pp-code-1201/Functional-Electrical-Stimulation/README.md

# Functional-Electrical-Stimulation
design of Functional-Electrical-Stimulation
