pp-code-1201/Functional-Electrical-Stimulation/fes测试结果总结/下肢_可实现的动作.docx

动作一：脚腕背屈，也称之为足内翻

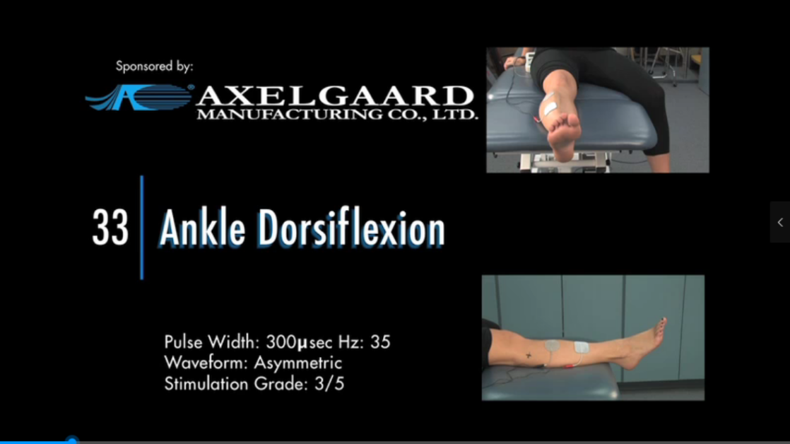
[picture p1: figure]
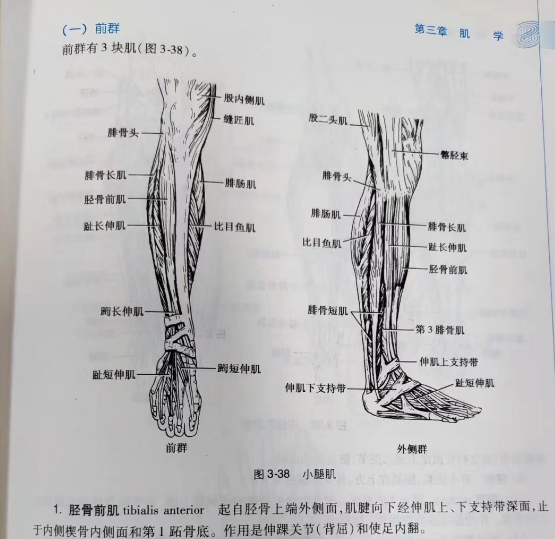
[picture p2: figure]

作用点为胫骨前肌

胫骨前肌位置：胫骨外侧面，也即腿部前侧远离身体的一侧，约在膝盖骨下侧5-10cm的位置，作用主要电极为下图的上方的电极片

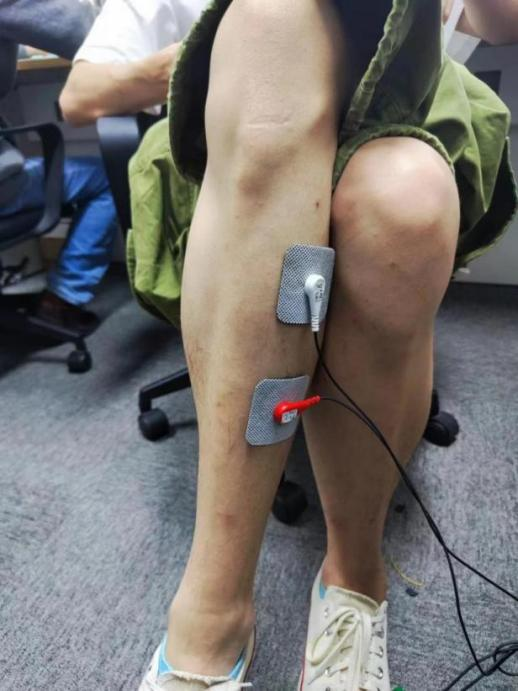
[picture p3: figure]
769a560509062b690e53f191cb9bba6
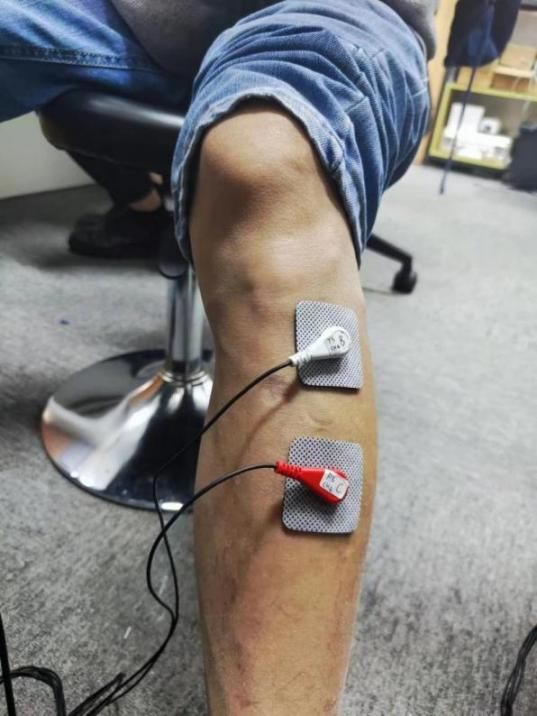
[picture p4: figure]
6eee9dab7c4d59fee65476bd0939f17
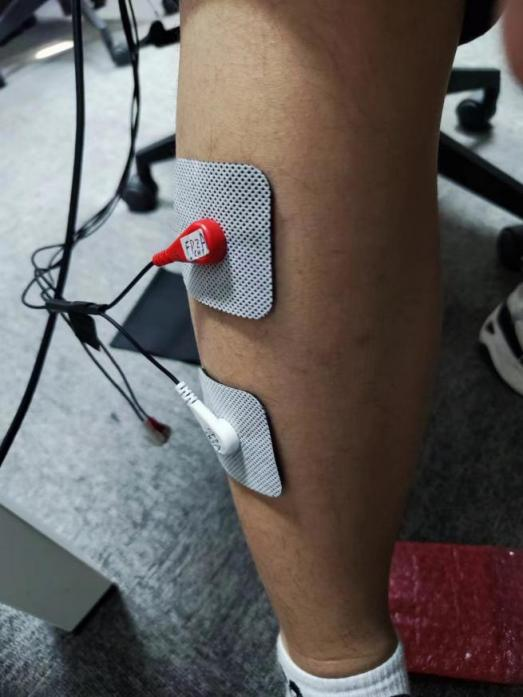
[picture p5: figure]
1687cea35207629f05cc6928171d927

电极片间距：4-4.5cm

电极片中心距：8cm

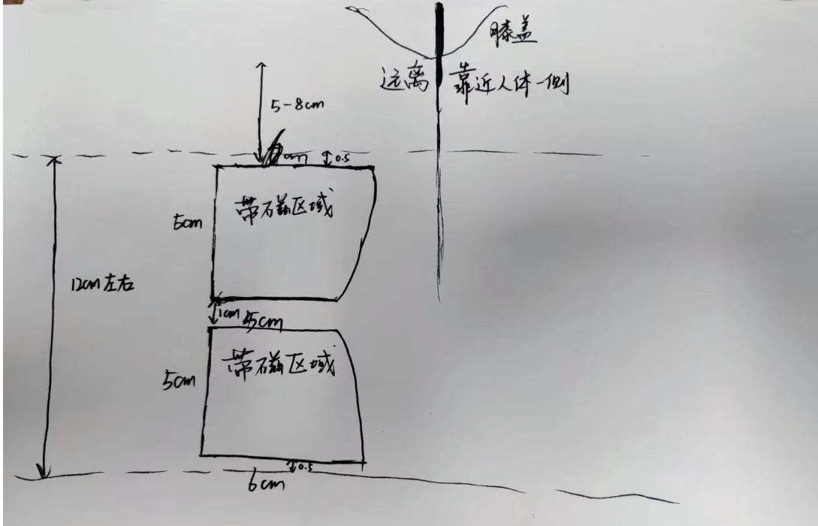
[picture p6: figure]
4de929856596f13bfcb09e4be4cfbc7
