pp-code-1201/Functional-Electrical-Stimulation/hardware/FES_SCH_V2.5.pdf

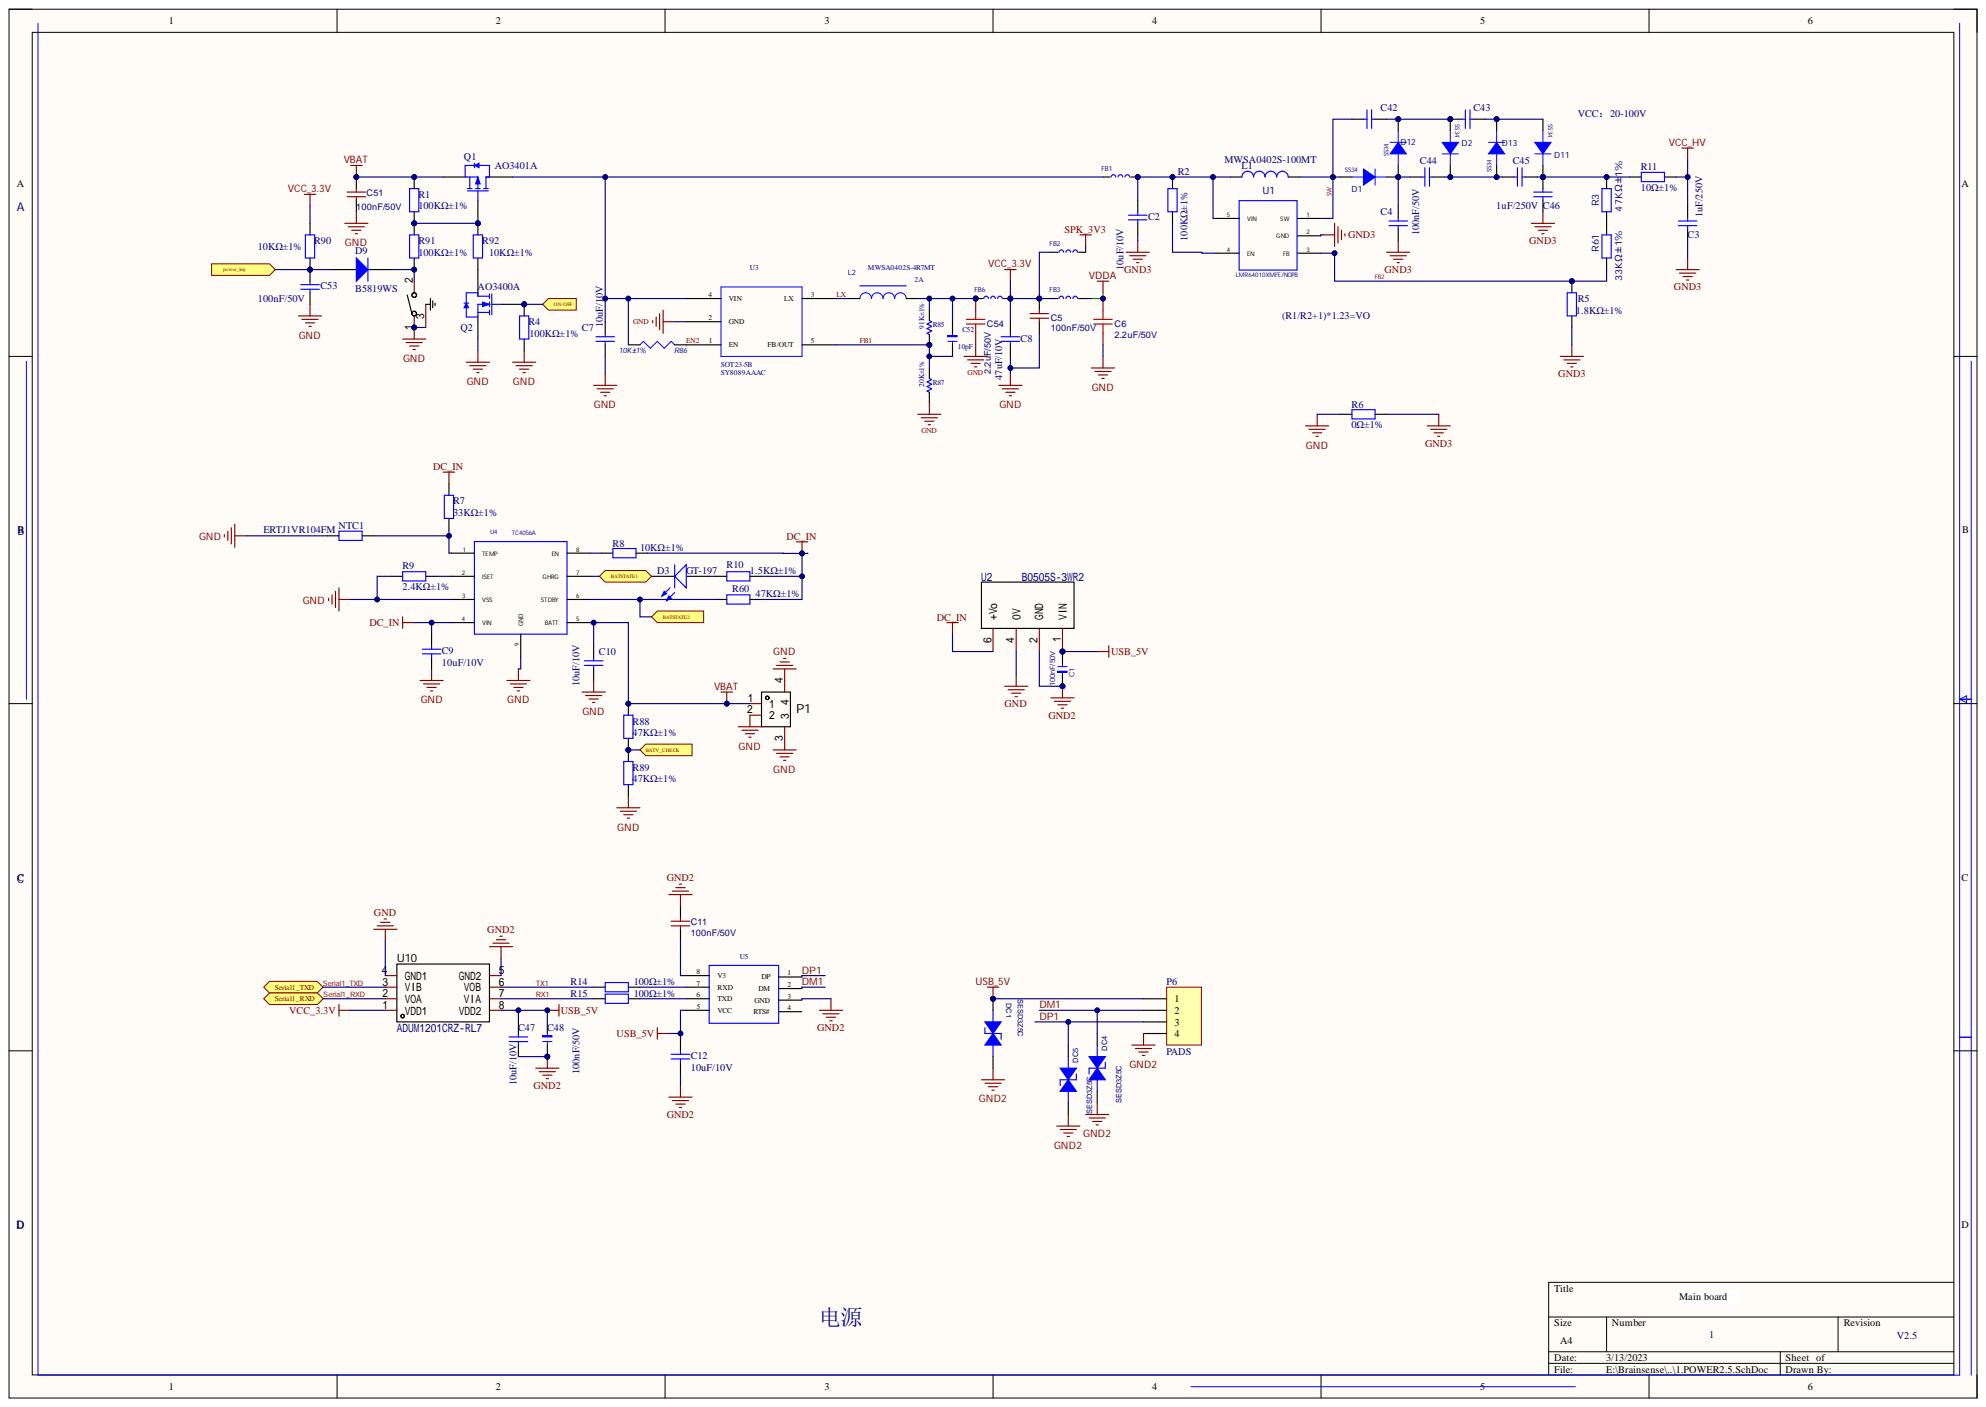
[picture p7: page 1]

GND 2

Size A4 | Number 1 | Revision V2.5

Date: 3/13/2023 | Sheet of
File: E:\Brainsense\..\1.POWER2.5.SchDoc | Drawn By:

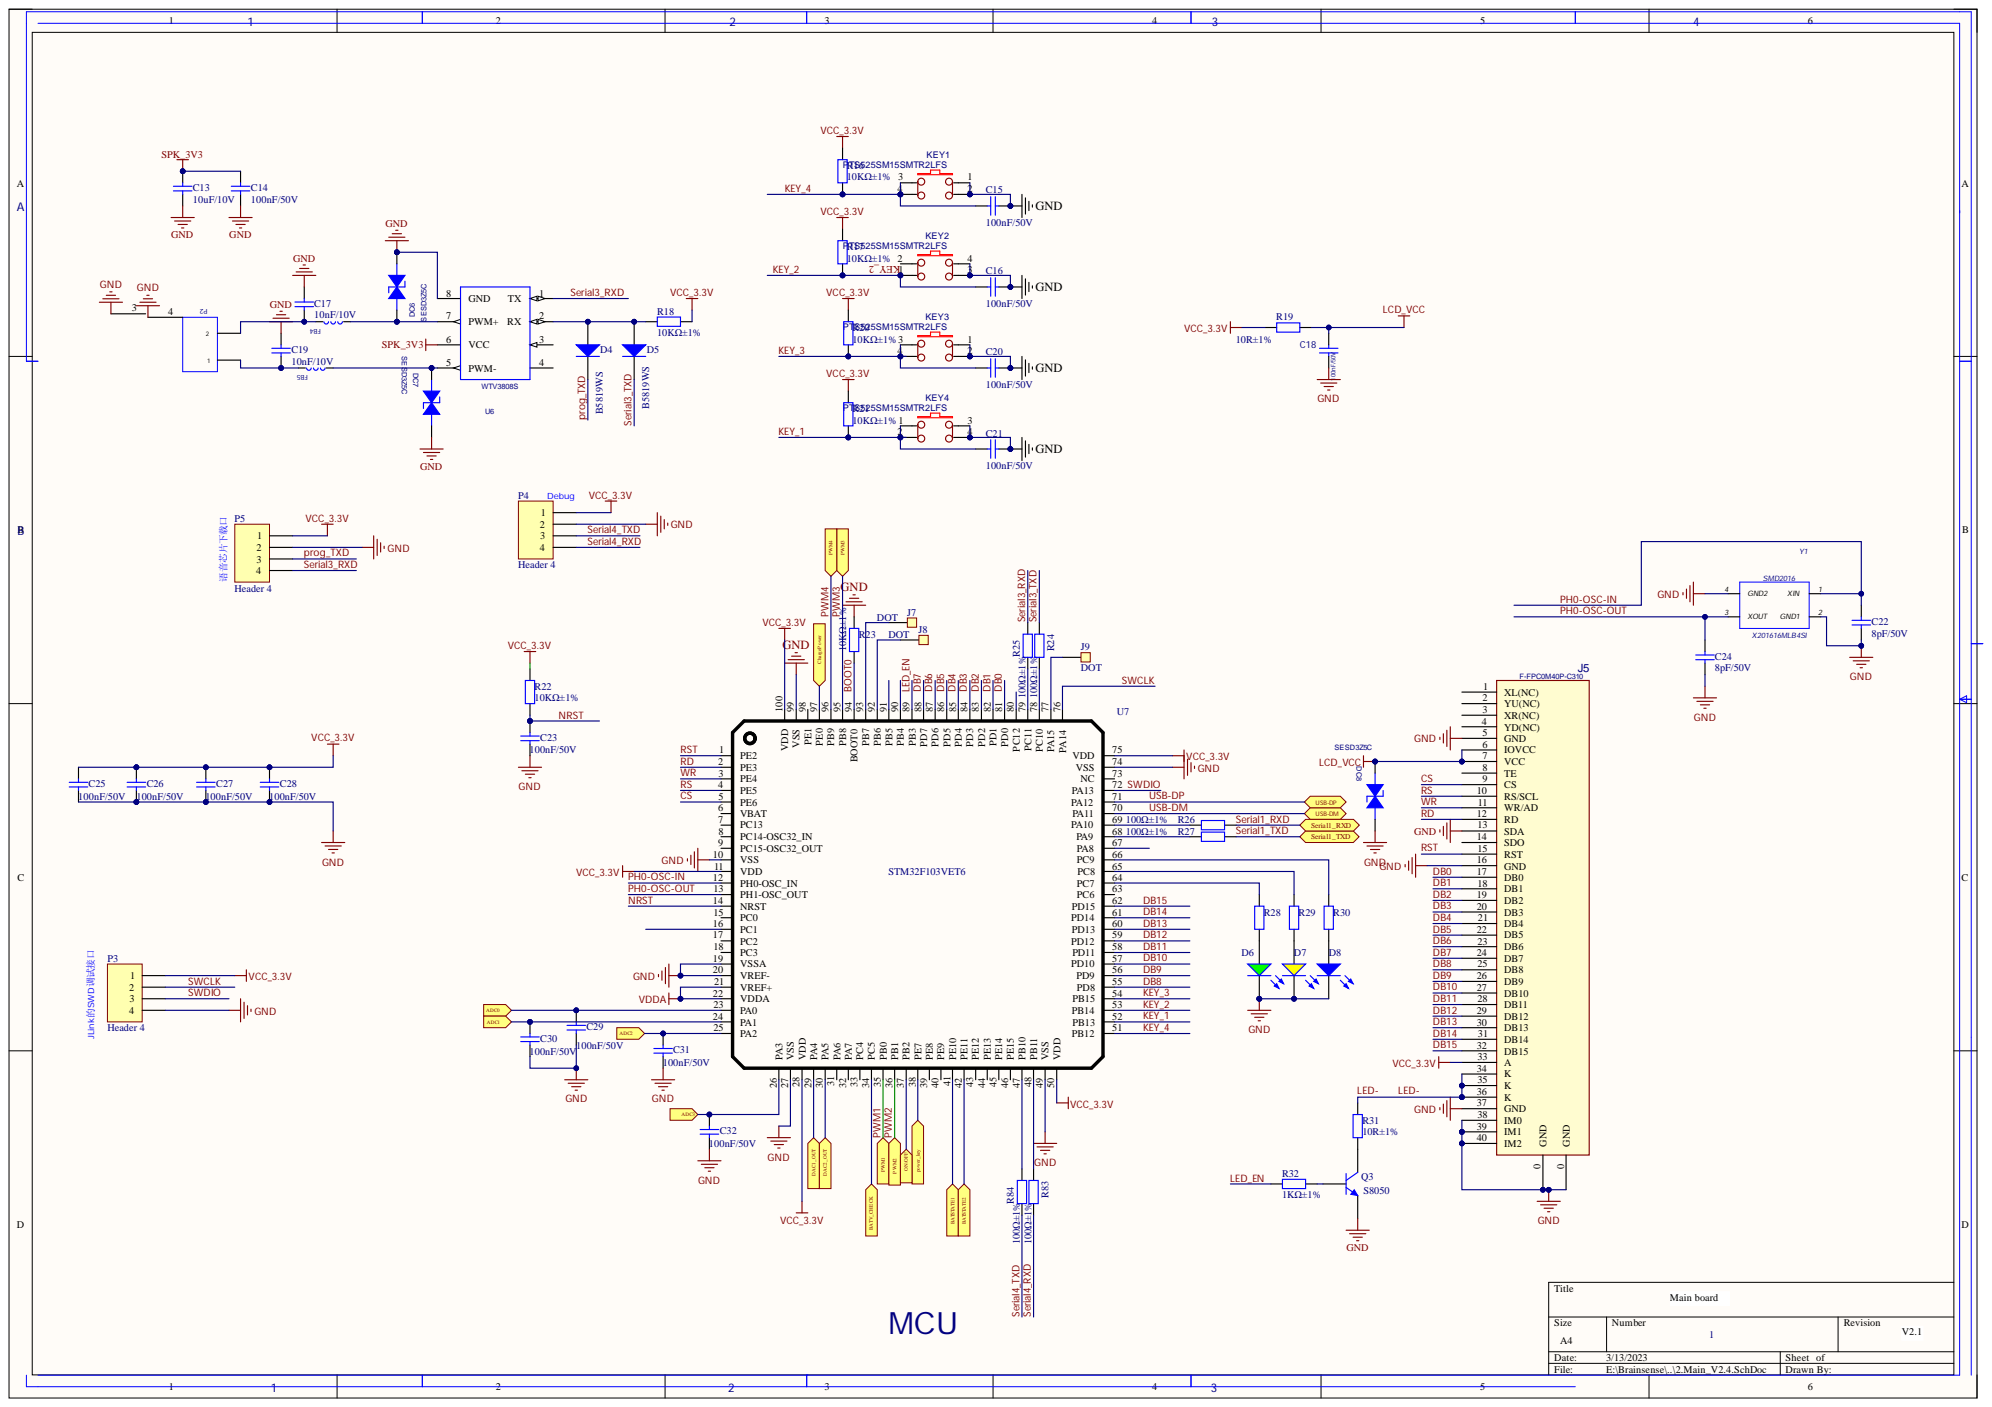
[picture p8: page 2]

Title

Size A4 | Nu mber | Revision

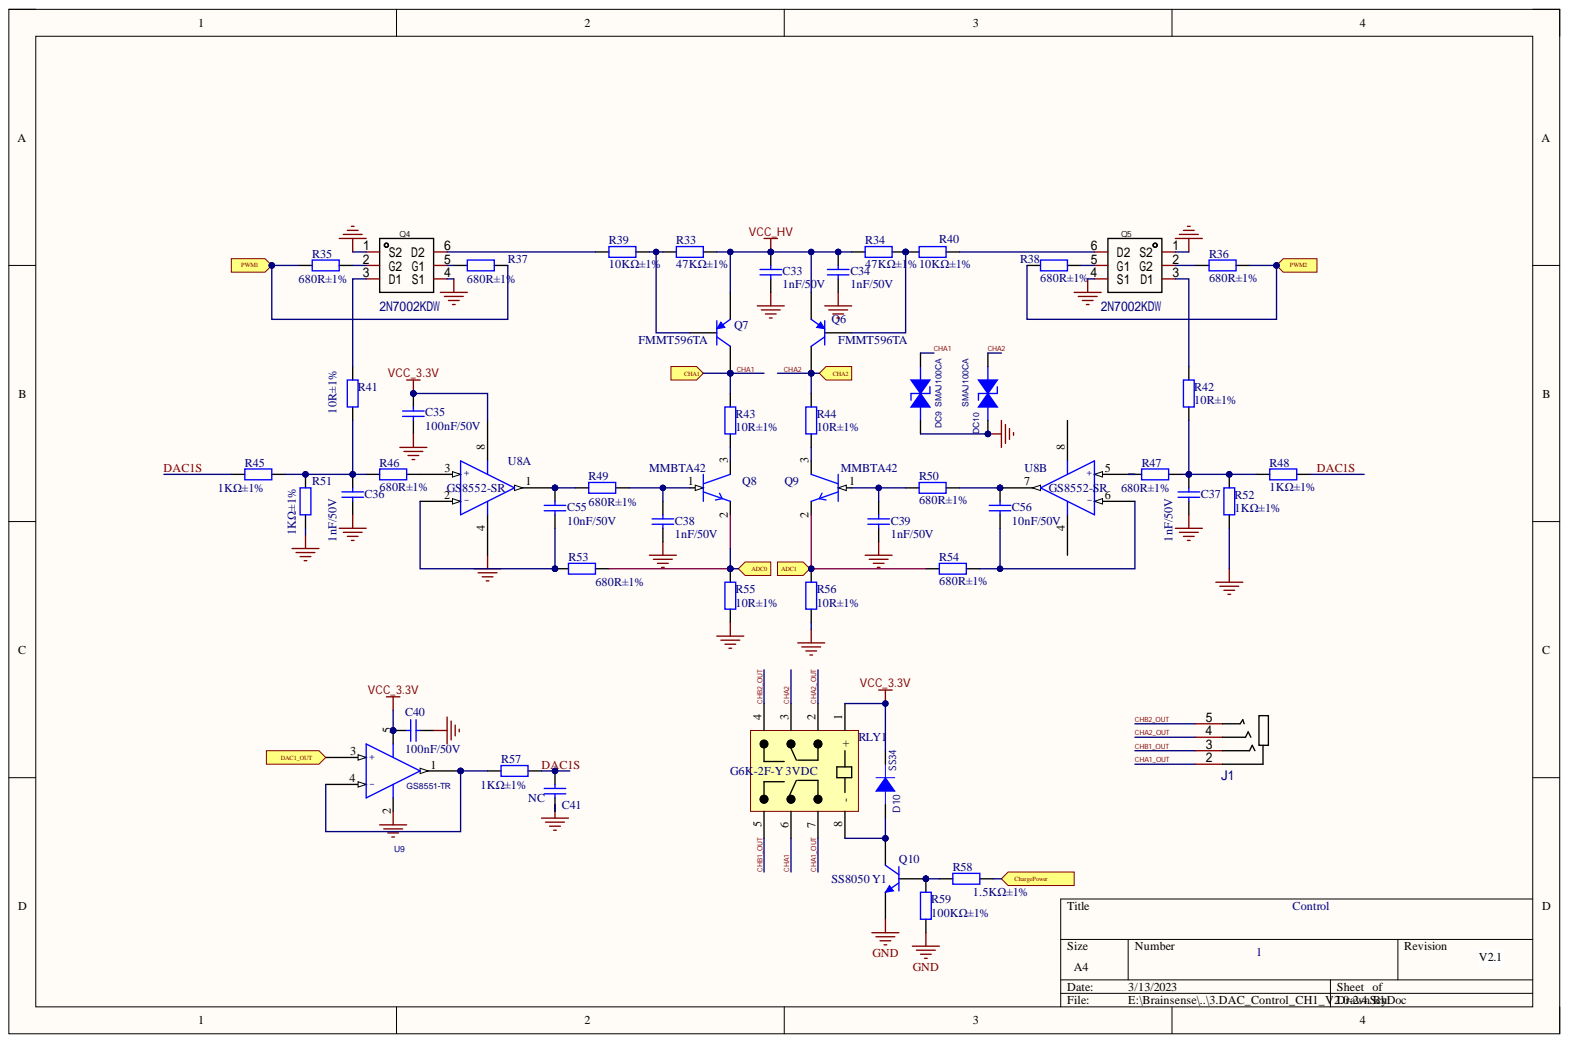
[picture p9: page 3]
