pp-code-1201/Functional-Electrical-Stimulation/(list of files, drawings)

Other design files:
hardware/1.POWER2.5.SchDoc
hardware/2.Main_V2.4.SchDoc
hardware/3.DAC_Control_CH1_V2.0-2.4.SchDoc
