pp-code-1201/Functional-Electrical-Stimulation/software/Core/Inc/main.h

#define LCD_RST_Pin GPIO_PIN_2
#define LCD_RST_GPIO_Port GPIOE
#define LCD_RD_Pin GPIO_PIN_3
#define LCD_RD_GPIO_Port GPIOE
#define LCD_WR_Pin GPIO_PIN_4
#define LCD_WR_GPIO_Port GPIOE
#define LCD_RS_Pin GPIO_PIN_5
#define LCD_RS_GPIO_Port GPIOE
#define LCD_CS_Pin GPIO_PIN_6
#define LCD_CS_GPIO_Port GPIOE
#define charge_full_Pin GPIO_PIN_7
#define charge_full_GPIO_Port GPIOA
#define charging_Pin GPIO_PIN_4
#define charging_GPIO_Port GPIOC
#define ON_OFF_Pin GPIO_PIN_2
#define ON_OFF_GPIO_Port GPIOB
#define POWER_KEY_Pin GPIO_PIN_7
#define POWER_KEY_GPIO_Port GPIOE
#define POWER_KEY_EXTI_IRQn EXTI9_5_IRQn
#define KEY_1_Pin GPIO_PIN_12
#define KEY_1_GPIO_Port GPIOB
#define KEY_1_EXTI_IRQn EXTI15_10_IRQn
#define KEY_4_Pin GPIO_PIN_13
#define KEY_4_GPIO_Port GPIOB
#define KEY_4_EXTI_IRQn EXTI15_10_IRQn
#define KEY_2_Pin GPIO_PIN_14
#define KEY_2_GPIO_Port GPIOB
#define KEY_2_EXTI_IRQn EXTI15_10_IRQn
#define KEY_3_Pin GPIO_PIN_15
#define KEY_3_GPIO_Port GPIOB
#define KEY_3_EXTI_IRQn EXTI15_10_IRQn
#define LED_B_Pin GPIO_PIN_7
#define LED_B_GPIO_Port GPIOC
#define LED_Y_Pin GPIO_PIN_8
#define LED_Y_GPIO_Port GPIOC
#define LED_R_Pin GPIO_PIN_9
#define LED_R_GPIO_Port GPIOC
#define LCD_BL_Pin GPIO_PIN_3
#define LCD_BL_GPIO_Port GPIOB
#define channel_switch_Pin GPIO_PIN_0
#define channel_switch_GPIO_Port GPIOE
