pp-code-1201/Functional-Electrical-Stimulation/software/Core/Src/usart.c

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
/* Includes ------------------------------------------------------------------*/
#include "usart.h"

/* USER CODE BEGIN 0 */
uint8_t  USART1_RX_BUF[USART_RX_LEN] = {0}; 
uint16_t USART1_RX_STA=0;   
uint8_t  ReviceState1 = 0;

/* USER CODE END 0 */

UART_HandleTypeDef huart4;
UART_HandleTypeDef huart1;
UART_HandleTypeDef huart3;

/* UART4 init function */
void MX_UART4_Init(void)
{

  huart4.Instance = UART4;
  huart4.Init.BaudRate = 9600;
  huart4.Init.WordLength = UART_WORDLENGTH_8B;
  huart4.Init.StopBits = UART_STOPBITS_1;
  huart4.Init.Parity = UART_PARITY_NONE;
  huart4.Init.Mode = UART_MODE_TX_RX;
  huart4.Init.HwFlowCtl = UART_HWCONTROL_NONE;
  huart4.Init.OverSampling = UART_OVERSAMPLING_16;
  if (HAL_UART_Init(&huart4) != HAL_OK)
  {
    Error_Handler();
  }
}
/* USART1 init function */

void MX_USART1_UART_Init(void)
{

  huart1.Instance = USART1;
  huart1.Init.BaudRate = 115200;
  huart1.Init.WordLength = UART_WORDLENGTH_8B;
  huart1.Init.StopBits = UART_STOPBITS_1;
  huart1.Init.Parity = UART_PARITY_NONE;
  huart1.Init.Mode = UART_MODE_TX_RX;
  huart1.Init.HwFlowCtl = UART_HWCONTROL_NONE;
  huart1.Init.OverSampling = UART_OVERSAMPLING_16;
  if (HAL_UART_Init(&huart1) != HAL_OK)
  {
    Error_Handler();
  }
  /* USER CODE BEGIN USART1_Init 2 */
  __HAL_UART_ENABLE_IT(&huart1, UART_IT_RXNE);
	__HAL_UART_ENABLE_IT(&huart1, UART_IT_IDLE);
  /* USER CODE END USART1_Init 2 */

}
/* USART3 init function */

void MX_USART3_UART_Init(void)
{

  huart3.Instance = USART3;
  huart3.Init.BaudRate = 115200;
  huart3.Init.WordLength = UART_WORDLENGTH_8B;
  huart3.Init.StopBits = UART_STOPBITS_1;
  huart3.Init.Parity = UART_PARITY_NONE;
  huart3.Init.Mode = UART_MODE_TX_RX;
  huart3.Init.HwFlowCtl = UART_HWCONTROL_NONE;
  huart3.Init.OverSampling = UART_OVERSAMPLING_16;
  if (HAL_UART_Init(&huart3) != HAL_OK)
  {
    Error_Handler();
  }
}

void HAL_UART_MspInit(UART_HandleTypeDef* uartHandle)
{

  GPIO_InitTypeDef GPIO_InitStruct = {0};
  if(uartHandle->Instance==UART4)
  {
    /* UART4 clock enable */
    __HAL_RCC_UART4_CLK_ENABLE();

    __HAL_RCC_GPIOC_CLK_ENABLE();
    /**UART4 GPIO Configuration
    PC10     ------> UART4_TX
    PC11     ------> UART4_RX
    */
    GPIO_InitStruct.Pin = GPIO_PIN_10;
    GPIO_InitStruct.Mode = GPIO_MODE_AF_PP;
    GPIO_InitStruct.Speed = GPIO_SPEED_FREQ_HIGH;
    HAL_GPIO_Init(GPIOC, &GPIO_InitStruct);

    GPIO_InitStruct.Pin = GPIO_PIN_11;
    GPIO_InitStruct.Mode = GPIO_MODE_INPUT;
    GPIO_InitStruct.Pull = GPIO_NOPULL;
    HAL_GPIO_Init(GPIOC, &GPIO_InitStruct);

    /* UART4 interrupt Init */
    HAL_NVIC_SetPriority(UART4_IRQn, 4, 0);
    HAL_NVIC_EnableIRQ(UART4_IRQn);
  }
  else if(uartHandle->Instance==USART1)
  {
    /* USART1 clock enable */
    __HAL_RCC_USART1_CLK_ENABLE();

    __HAL_RCC_GPIOA_CLK_ENABLE();
    /**USART1 GPIO Configuration
    PA9     ------> USART1_TX
    PA10     ------> USART1_RX
    */
    GPIO_InitStruct.Pin = GPIO_PIN_9;
    GPIO_InitStruct.Mode = GPIO_MODE_AF_PP;
    GPIO_InitStruct.Speed = GPIO_SPEED_FREQ_HIGH;
    HAL_GPIO_Init(GPIOA, &GPIO_InitStruct);

    GPIO_InitStruct.Pin = GPIO_PIN_10;
    GPIO_InitStruct.Mode = GPIO_MODE_INPUT;
    GPIO_InitStruct.Pull = GPIO_NOPULL;
    HAL_GPIO_Init(GPIOA, &GPIO_InitStruct);

    /* USART1 interrupt Init */
    HAL_NVIC_SetPriority(USART1_IRQn, 3, 0);
    HAL_NVIC_EnableIRQ(USART1_IRQn);
  }
  else if(uartHandle->Instance==USART3)
  {
    /* USART3 clock enable */
    __HAL_RCC_USART3_CLK_ENABLE();

    __HAL_RCC_GPIOB_CLK_ENABLE();
    /**USART3 GPIO Configuration
    PB10     ------> USART3_TX
    PB11     ------> USART3_RX
    */
    GPIO_InitStruct.Pin = GPIO_PIN_10;
    GPIO_InitStruct.Mode = GPIO_MODE_AF_PP;
    GPIO_InitStruct.Speed = GPIO_SPEED_FREQ_HIGH;
    HAL_GPIO_Init(GPIOB, &GPIO_InitStruct);

    GPIO_InitStruct.Pin = GPIO_PIN_11;
    GPIO_InitStruct.Mode = GPIO_MODE_INPUT;
    GPIO_InitStruct.Pull = GPIO_NOPULL;
    HAL_GPIO_Init(GPIOB, &GPIO_InitStruct);

  }
}

void HAL_UART_MspDeInit(UART_HandleTypeDef* uartHandle)
{

  if(uartHandle->Instance==UART4)
  {
    /* Peripheral clock disable */
    __HAL_RCC_UART4_CLK_DISABLE();

    /**UART4 GPIO Configuration
    PC10     ------> UART4_TX
    PC11     ------> UART4_RX
    */
    HAL_GPIO_DeInit(GPIOC, GPIO_PIN_10|GPIO_PIN_11);

    /* UART4 interrupt Deinit */
    HAL_NVIC_DisableIRQ(UART4_IRQn);
  }
  else if(uartHandle->Instance==USART1)
  {
    /* Peripheral clock disable */
    __HAL_RCC_USART1_CLK_DISABLE();

    /**USART1 GPIO Configuration
    PA9     ------> USART1_TX
    PA10     ------> USART1_RX
    */
    HAL_GPIO_DeInit(GPIOA, GPIO_PIN_9|GPIO_PIN_10);

    /* USART1 interrupt Deinit */
    HAL_NVIC_DisableIRQ(USART1_IRQn);
  }
  else if(uartHandle->Instance==USART3)
  {
    /* Peripheral clock disable */
    __HAL_RCC_USART3_CLK_DISABLE();

    /**USART3 GPIO Configuration
    PB10     ------> USART3_TX
    PB11     ------> USART3_RX
    */
    HAL_GPIO_DeInit(GPIOB, GPIO_PIN_10|GPIO_PIN_11);

  }
}

/* USER CODE BEGIN 1 */
void HAL_USART1_IRQHandler_Callback(void)
{
    uint8_t temp;
		if(__HAL_UART_GET_FLAG(&huart1, UART_FLAG_RXNE)!=RESET)
		{
				temp=huart1.Instance->DR;
				USART1_RX_BUF[USART1_RX_STA++]=temp;
				__HAL_UART_CLEAR_FLAG(&huart1,UART_FLAG_RXNE);  
		}
		else if(__HAL_UART_GET_FLAG(&huart1, UART_FLAG_IDLE)!=RESET)
		{
				temp=huart1.Instance->DR; 	
				ReviceState1 = 1;
				//printf("rcv: %02X %02X \r", USART1_RX_BUF[0], USART1_RX_BUF[2]);
				__HAL_UART_CLEAR_IDLEFLAG(&huart1);
		}
		else
		{
      	ReviceState1 = 0;
				USART1_RX_STA=0; 
		}
}

#ifdef __DEBUG__
/**************************************************************************
  * Function:	  
  * 		 fputc
  * Description: 
  * 		 redefine fputc ,usart log
  * Parameters:  
  * 		 [void]
  * Return: 	 
  * 		 none
*****************************************************************************/
int fputc(int ch, FILE *f)
{     
    HAL_UART_Transmit(&huart3, (uint8_t *)&ch, 1, 10);
    return ch;
}
#endif
/* USER CODE END 1 */
