pp-code-1201/Functional-Electrical-Stimulation/software/Core/Inc/usart.h

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
/* Define to prevent recursive inclusion -------------------------------------*/
#ifndef __USART_H__
#define __USART_H__

#ifdef __cplusplus
extern "C" {
#endif

/* Includes ------------------------------------------------------------------*/
#include "main.h"

/* USER CODE BEGIN Includes */
#include <stdio.h>
#include "main.h"

/* USER CODE END Includes */

extern UART_HandleTypeDef huart4;

extern UART_HandleTypeDef huart1;

extern UART_HandleTypeDef huart3;

/* USER CODE BEGIN Private defines */
//#define __DEBUG__      //debug switch

#define USART_RX_LEN   200

#ifdef __DEBUG__
#define  BC_DEBUG(format, ...)   printf(format, ##__VA_ARGS__)
#else
#define  BC_DEBUG(format,...)
#endif


extern uint8_t  USART1_RX_BUF[USART_RX_LEN]; 
extern uint16_t USART1_RX_STA;   
extern uint8_t  ReviceState1;


/* USER CODE END Private defines */

void MX_UART4_Init(void);
void MX_USART1_UART_Init(void);
void MX_USART3_UART_Init(void);

/* USER CODE BEGIN Prototypes */
void HAL_USART1_IRQHandler_Callback(void);

/* USER CODE END Prototypes */

#ifdef __cplusplus
}
#endif

#endif /* __USART_H__ */
