pp-code-1201/Functional-Electrical-Stimulation/(commit log)

2023-03-17 “fes”
2023-03-17 “fes_pdm”
    [1.POWER2.5.SchDoc, 2.Main_V2.4.SchDoc, 3.DAC_Control_CH1_V2.0-2.4.SchDoc]
2023-03-17 “fes_test”
