pp-code-1201/Functional-Electrical-Stimulation/(notices)

Notices in the files:
software/Core/Src/dac.c:
Copyright (c) 2022 STMicroelectronics.
All rights reserved.
This software is licensed under terms that can be found in the LICENSE file
